coolcmyk/orion-freecad/references/camera_mechanical/dwg_front_view.png

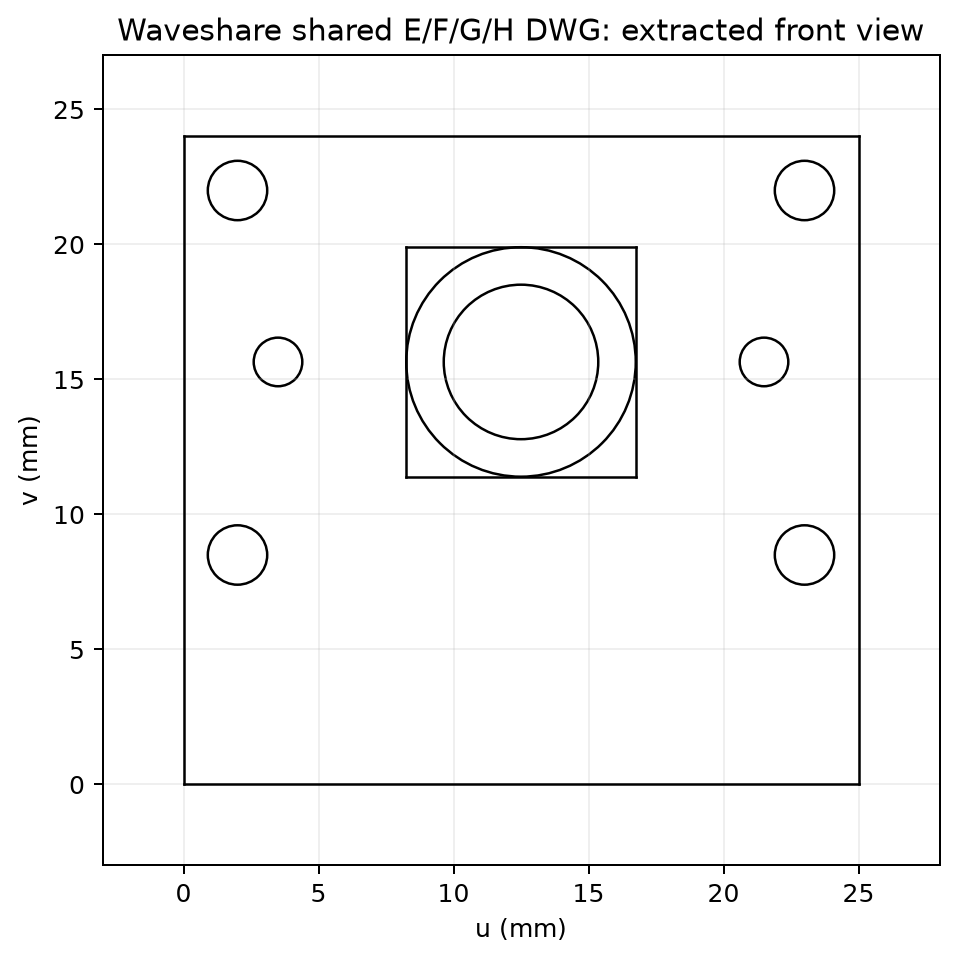
references/camera_mechanical/dwg_front_view.png
