coolcmyk/orion-freecad/screenshots/arm_top_esc_plan.png

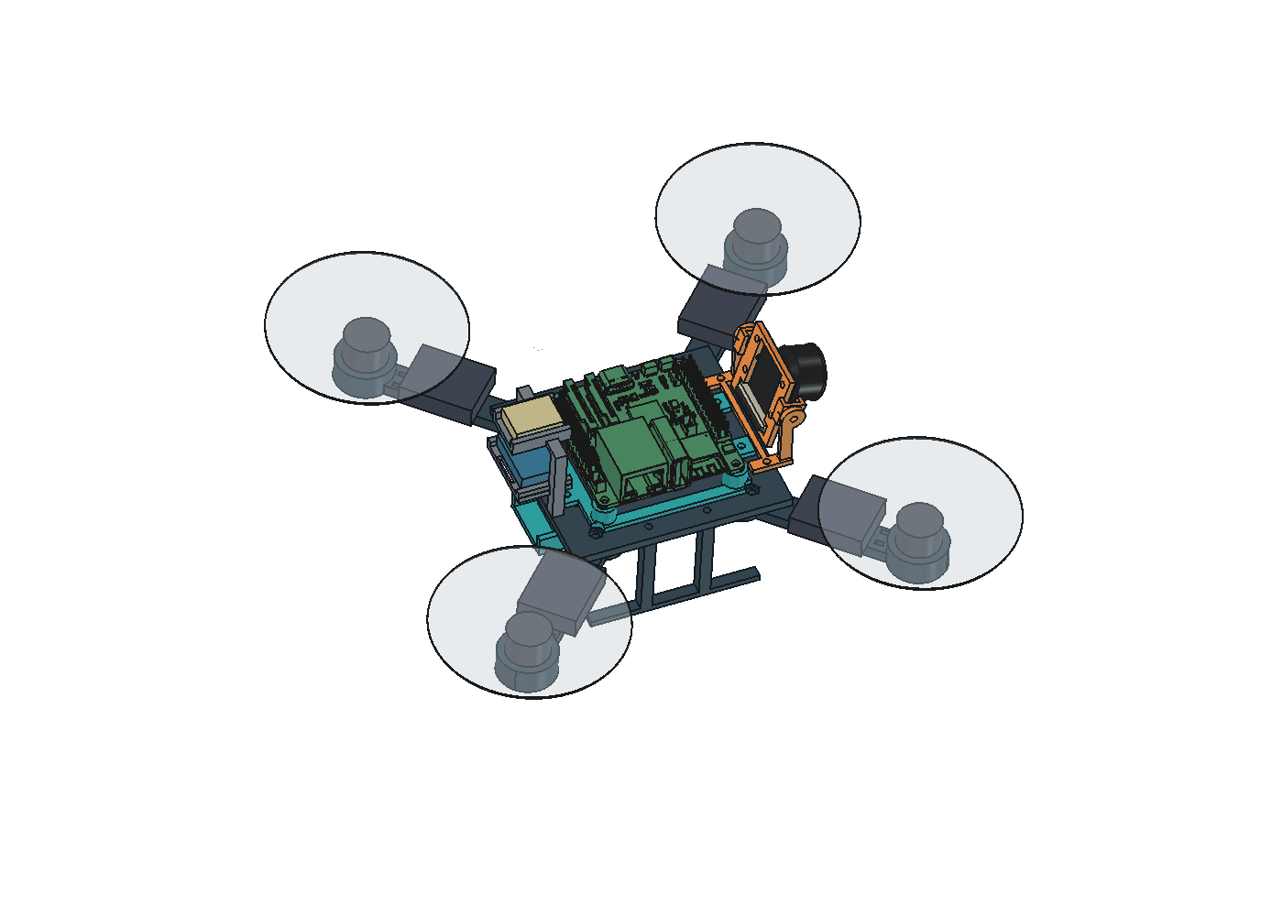
screenshots/arm_top_esc_plan.png
