coolcmyk/orion-freecad/screenshots/camera_forward_lean.png

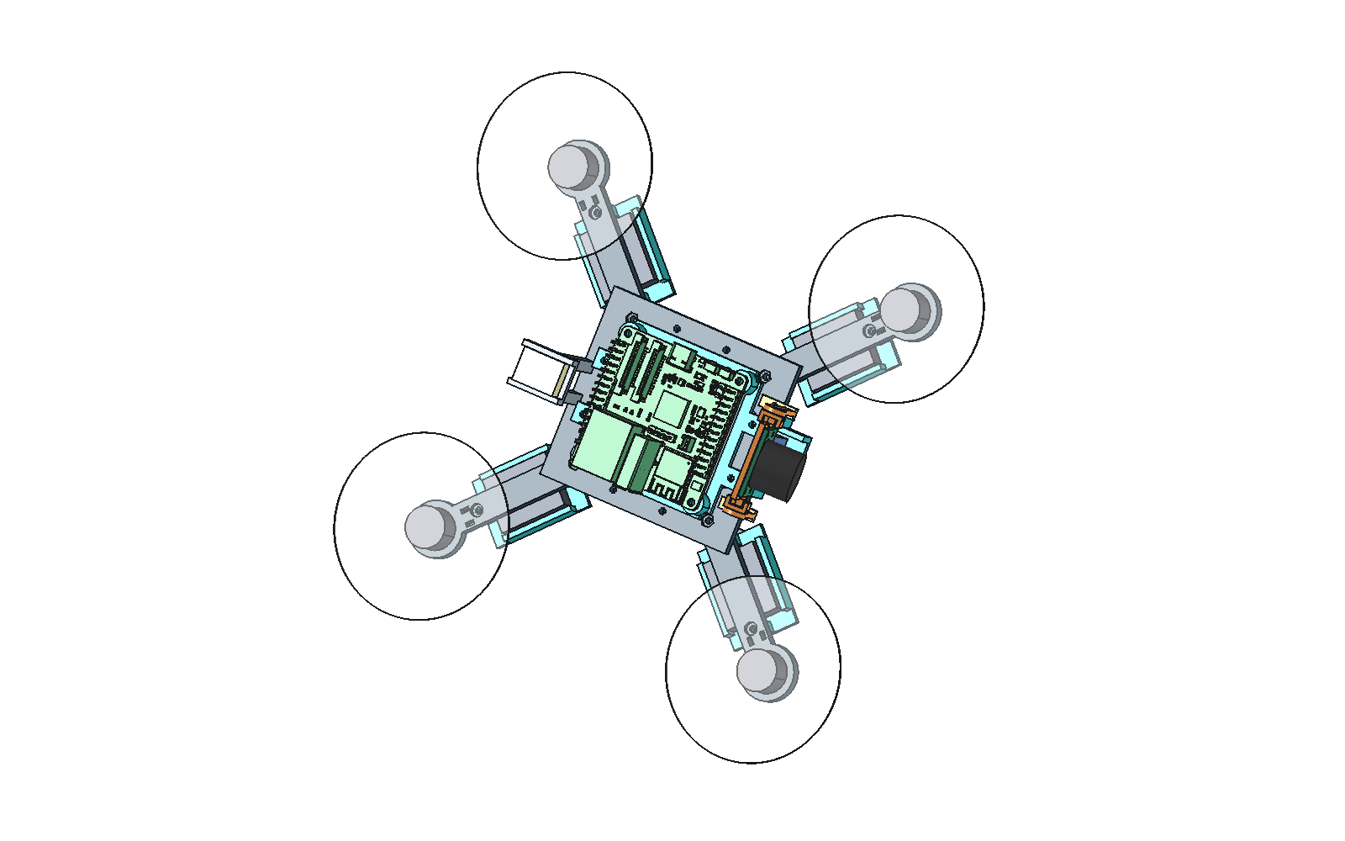
screenshots/camera_forward_lean.png
