coolcmyk/orion-freecad/screenshots/camera_g_integrated.png

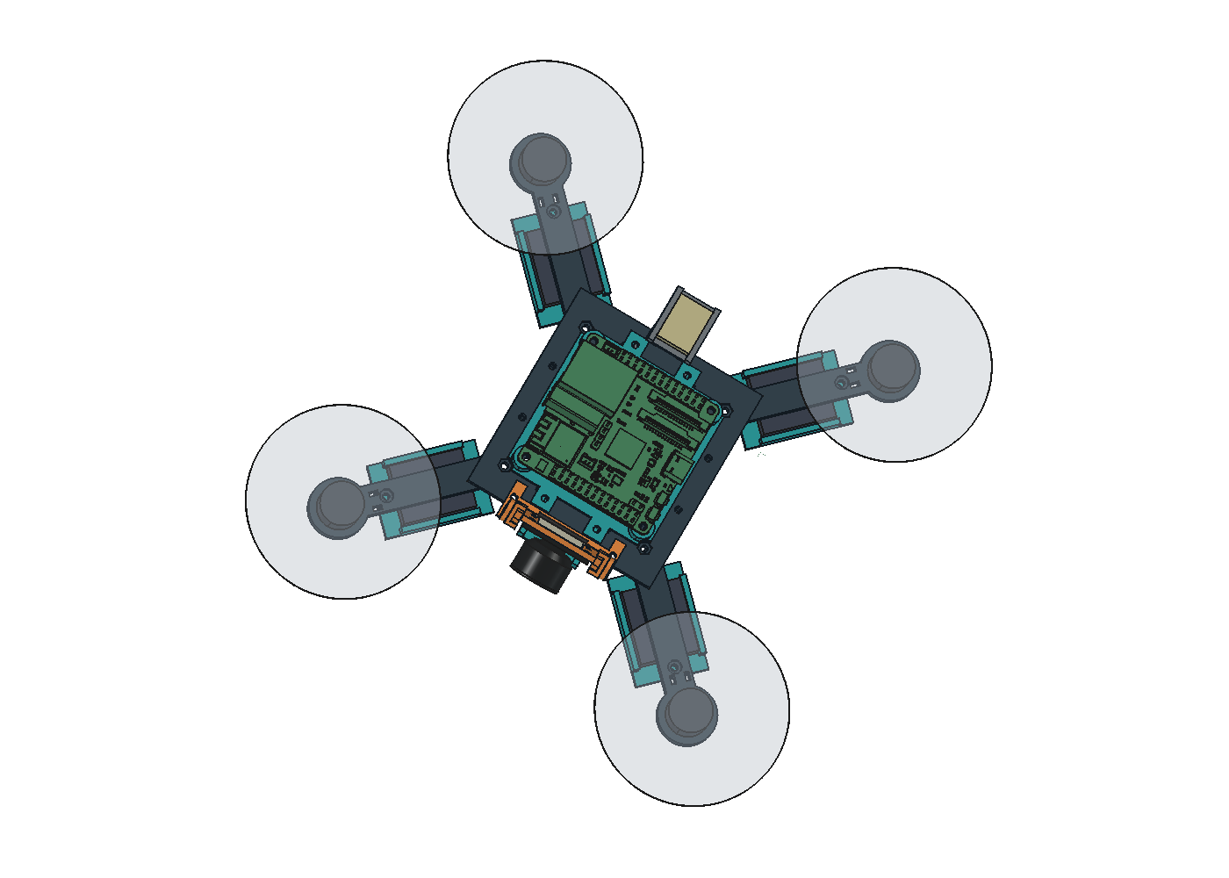
screenshots/camera_g_integrated.png
