coolcmyk/orion-freecad/screenshots/clearance_side.png

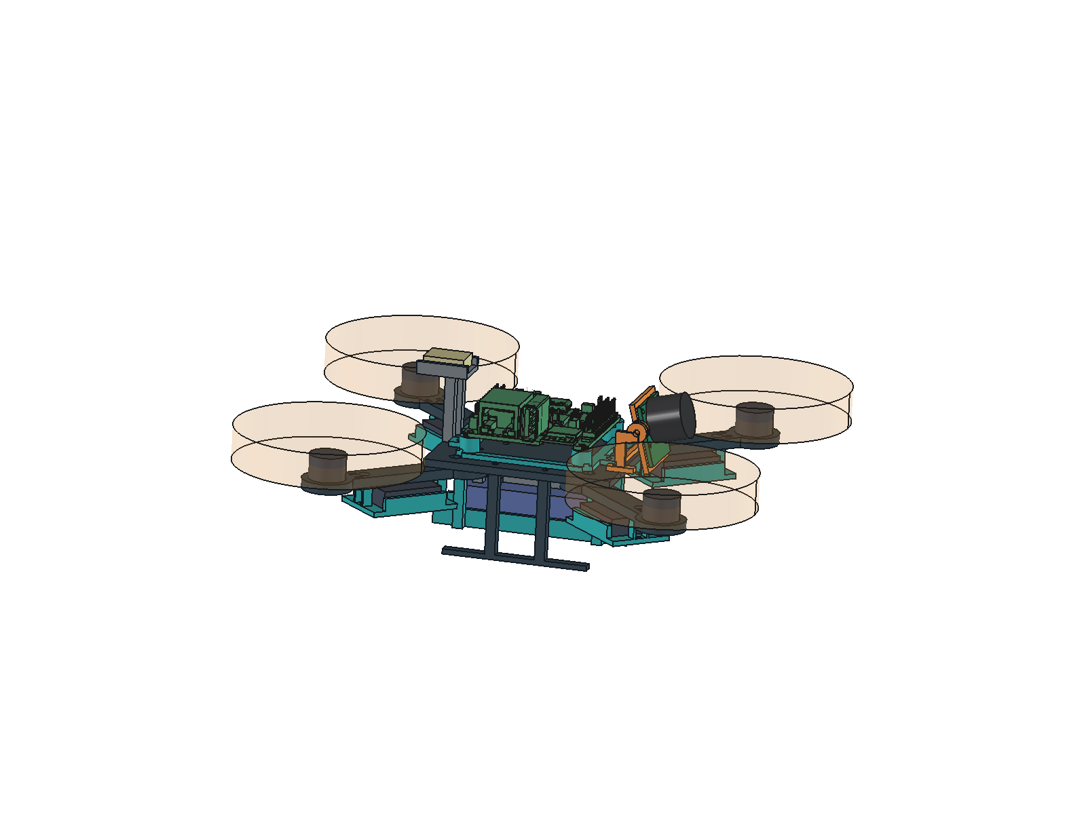
screenshots/clearance_side.png
