coolcmyk/orion-freecad/screenshots/isometric.png

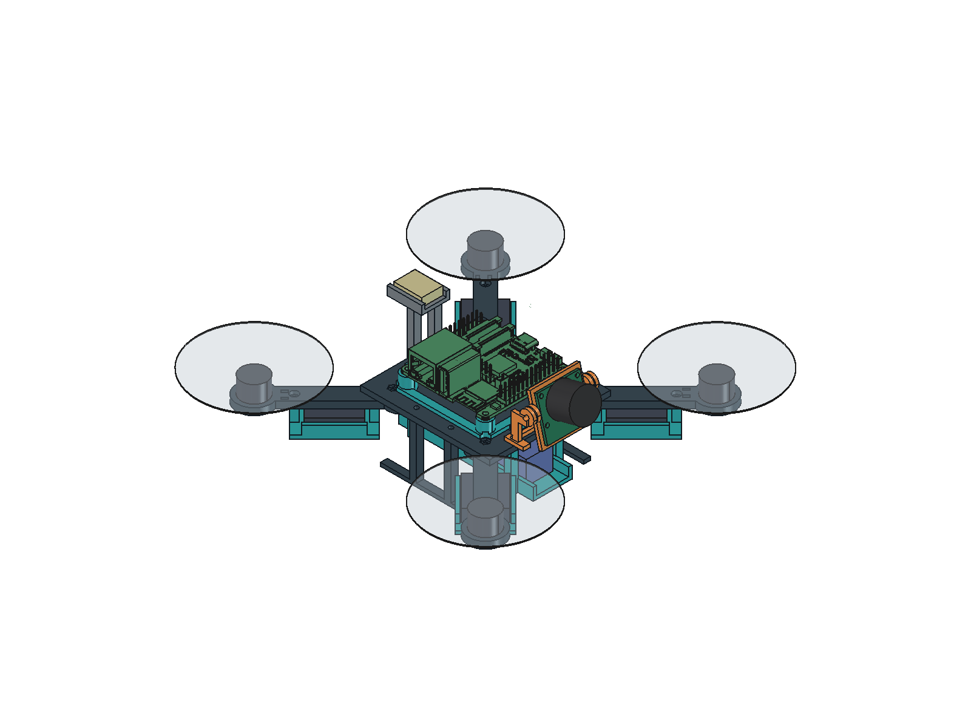
screenshots/isometric.png
