coolcmyk/orion-freecad/screenshots/sensor_battery_side.png

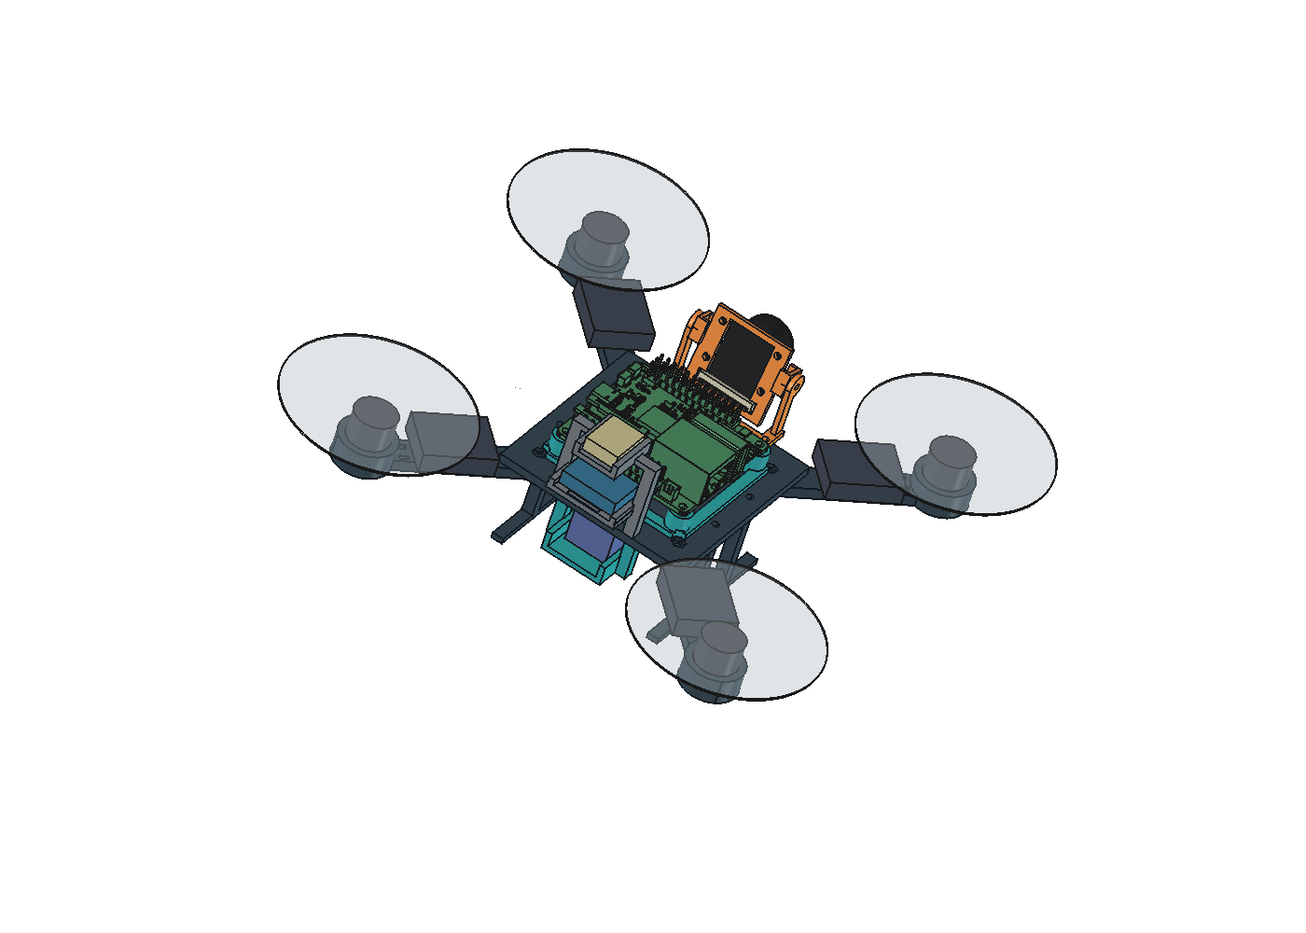
screenshots/sensor_battery_side.png
