coolcmyk/orion-freecad/screenshots/top.png

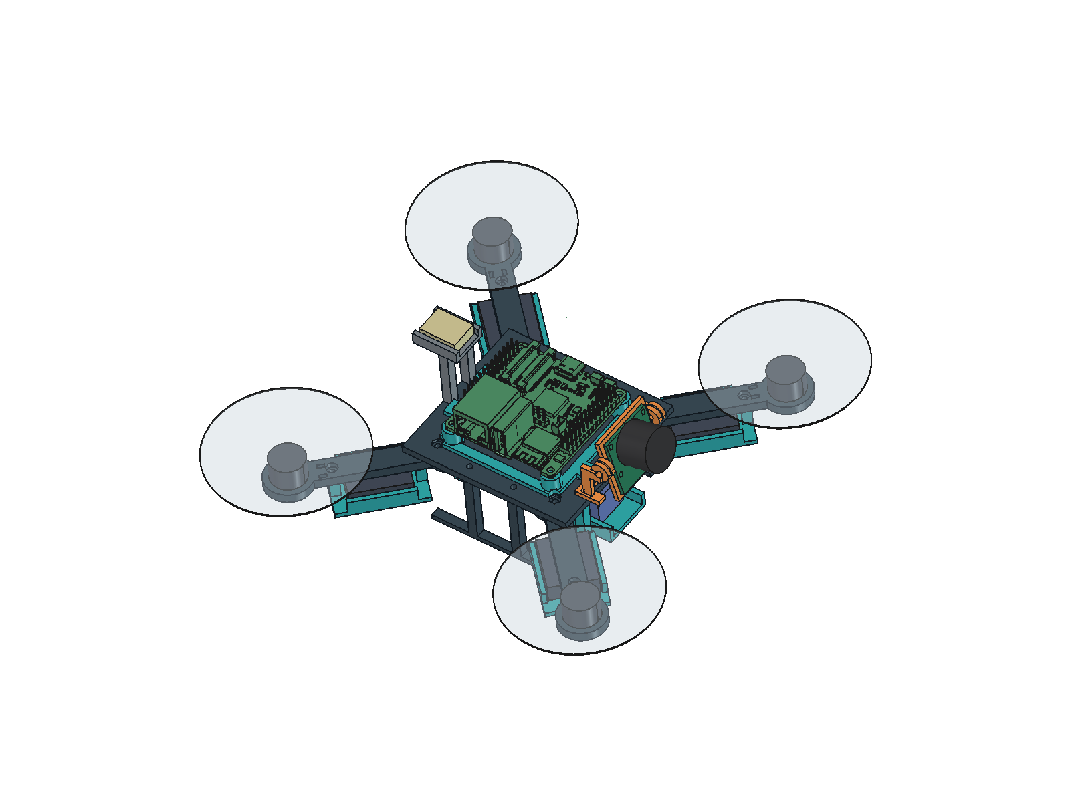
screenshots/top.png
