coolcmyk/orion-freecad/screenshots/exploded_printed_parts.png

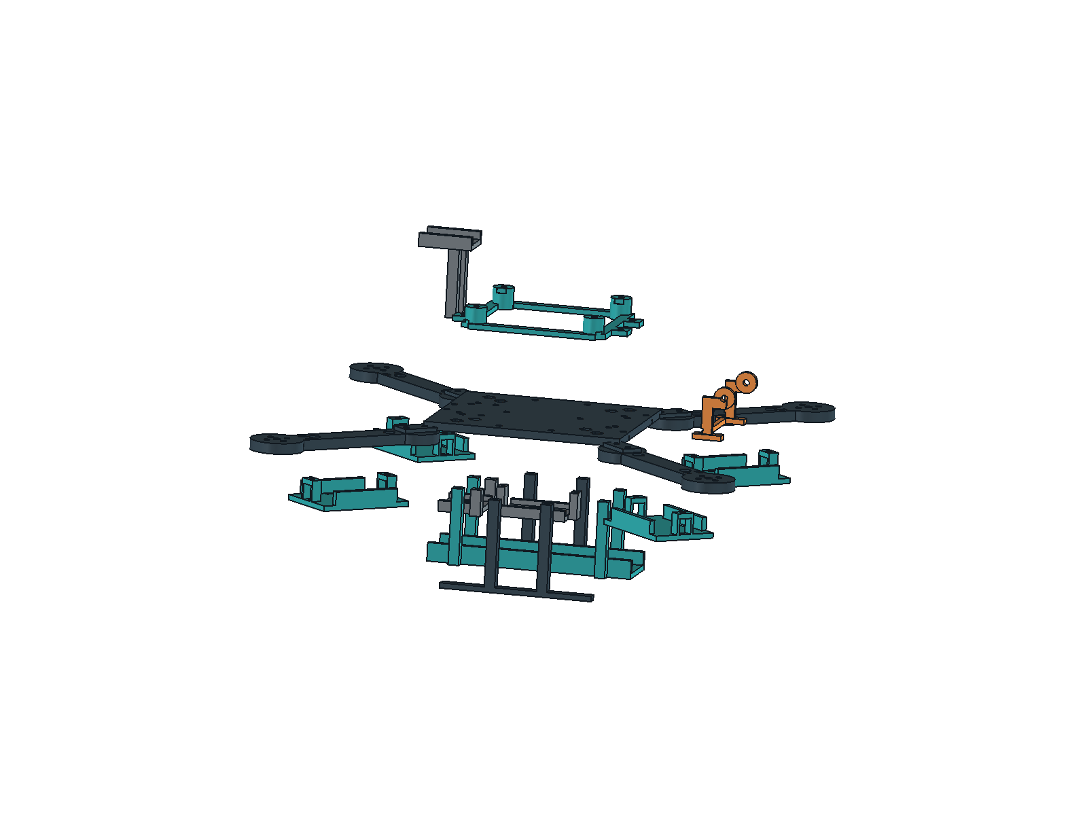
screenshots/exploded_printed_parts.png
