coolcmyk/orion-freecad/export/prototypes/ORION_center_base.stl

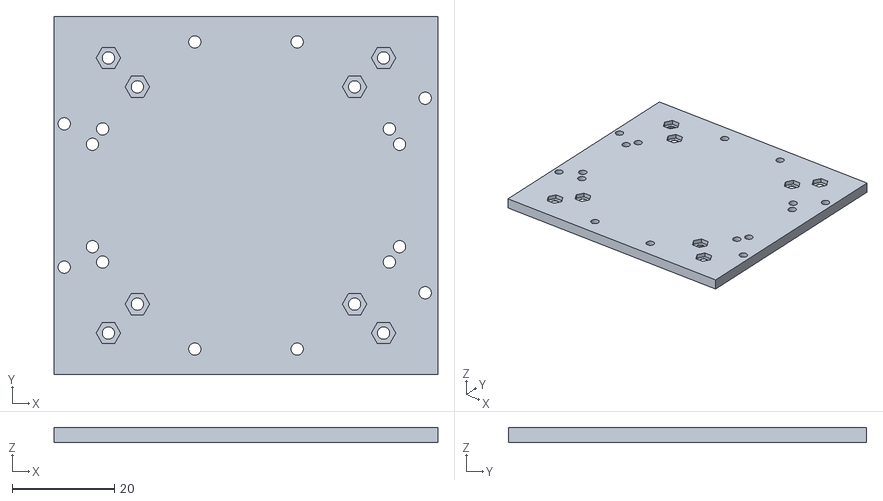
[picture p19: CAD file, 2026-10-10]
export/prototypes/ORION_center_base.stl
75.0 x 70.0 x 3.00
