coolcmyk/orion-freecad/references/camera_g_reconstructed/Waveshare_Camera_G.step

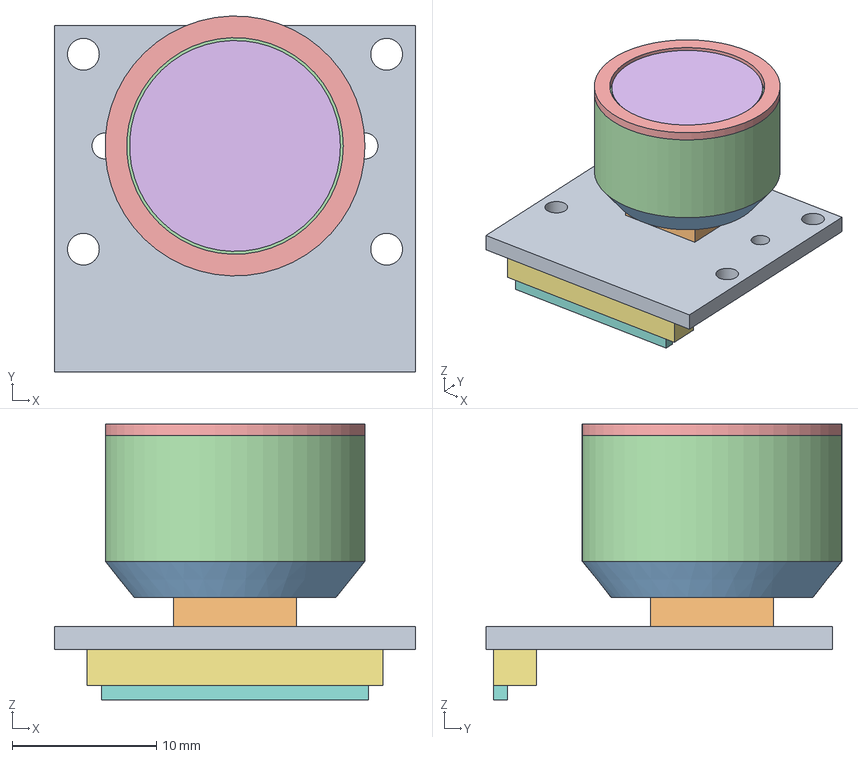
[picture p20: CAD file, 2026-10-10]
references/camera_g_reconstructed/Waveshare_Camera_G.step
25.0 x 24.6 x 19.1 mm
CameraGPCB
CameraGSensorHousing
CameraGLensShoulder
CameraGFisheyeBarrel
CameraGFocusRim
CameraGOpticalFace
CameraGRearFFC
CameraGFFCLatch
