coolcmyk/orion-freecad/export/prototypes/ORION_gps_mount.stl

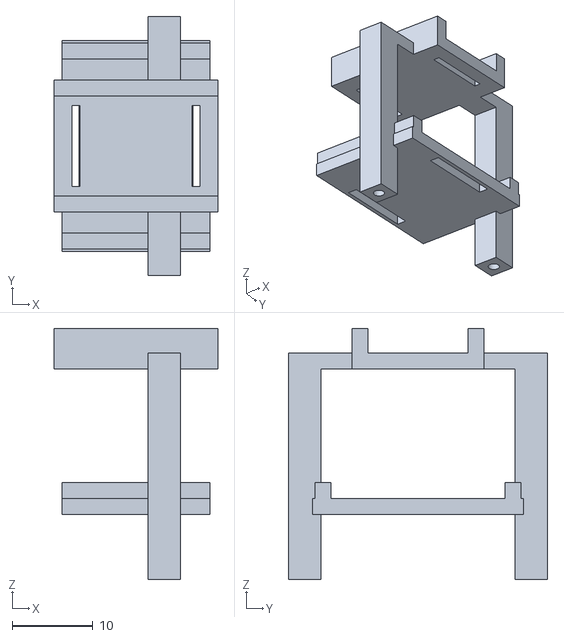
[picture p21: CAD file, 2026-10-10]
export/prototypes/ORION_gps_mount.stl
20.2 x 32.0 x 31.0
