coolcmyk/orion-freecad/export/prototypes/ORION_battery_mount.stl

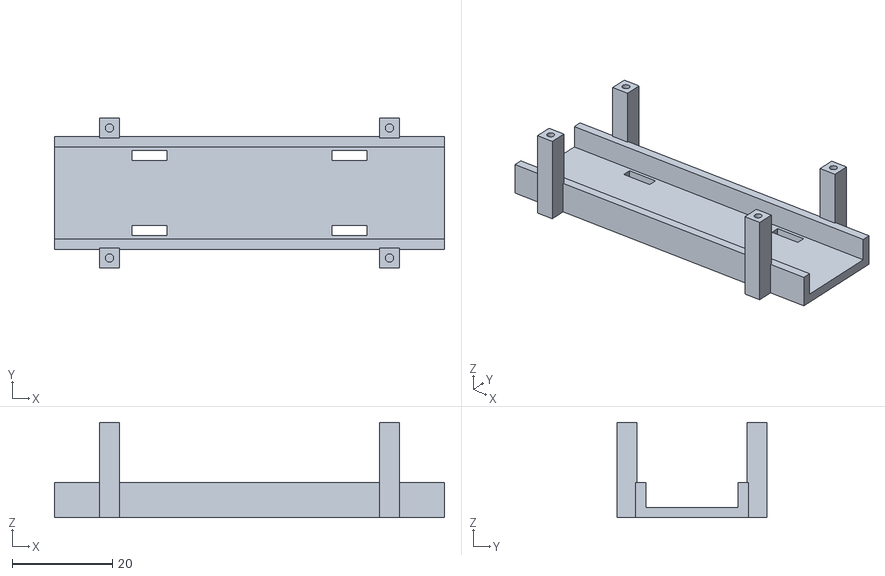
[picture p22: CAD file, 2026-10-10]
export/prototypes/ORION_battery_mount.stl
78.0 x 30.0 x 19.0
