coolcmyk/orion-freecad/export/prototypes/ORION_arm.stl

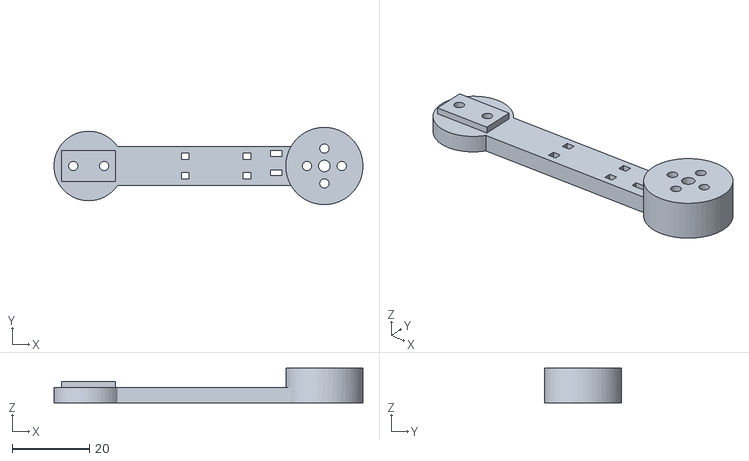
[picture p23: CAD file, 2026-10-10]
export/prototypes/ORION_arm.stl
80.0 x 20.0 x 9.00
