coolcmyk/orion-freecad/export/prototypes/ORION_camera_base_mount.stl

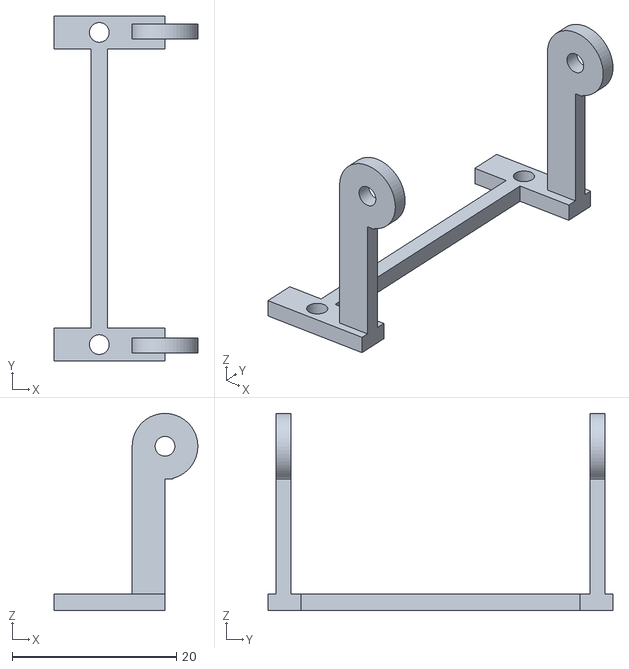
[picture p24: CAD file, 2026-10-10]
export/prototypes/ORION_camera_base_mount.stl
17.5 x 42.0 x 24.0
