coolcmyk/orion-freecad/export/prototypes/ORION_camera_mount.stl

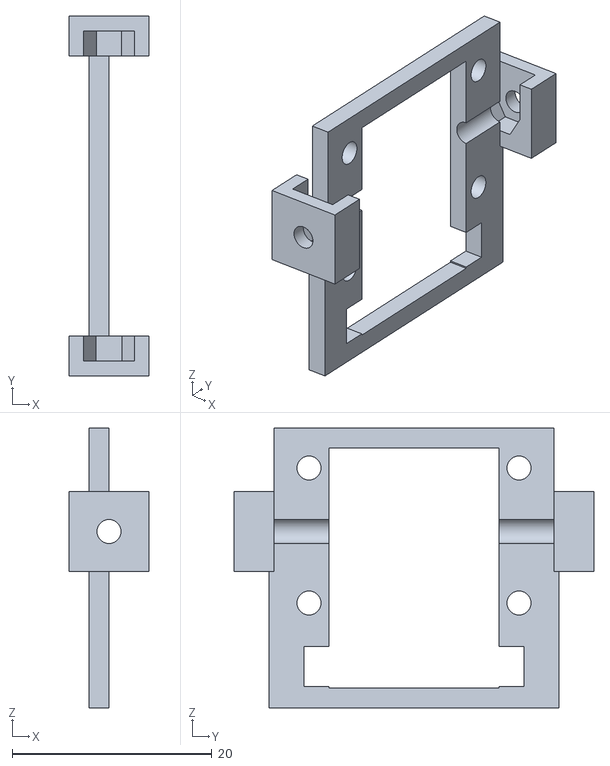
[picture p25: CAD file, 2026-10-10]
export/prototypes/ORION_camera_mount.stl
8.00 x 36.0 x 28.0
