coolcmyk/orion-freecad/export/prototypes/ORION_tolerance_coupon.stl

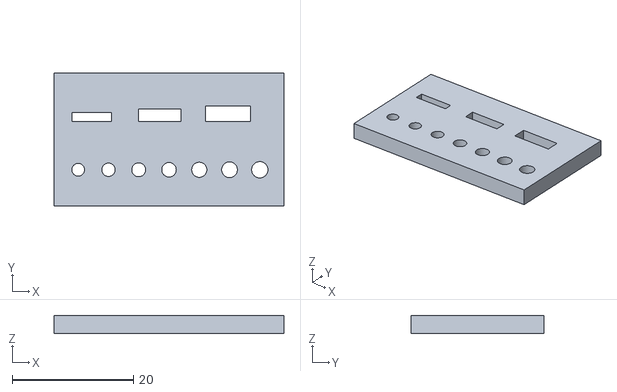
[picture p26: CAD file, 2026-10-10]
export/prototypes/ORION_tolerance_coupon.stl
38.0 x 22.0 x 3.00
