coolcmyk/orion-freecad/export/prototypes/ORION_p4_holder.stl

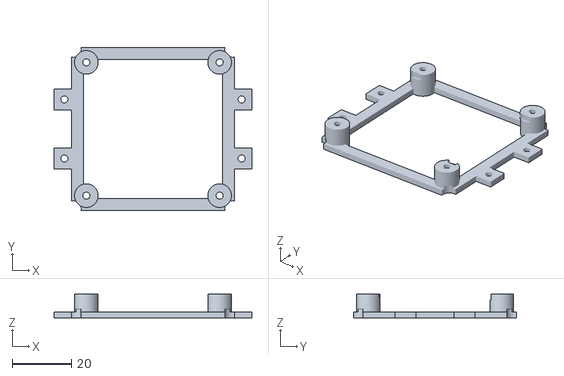
[picture p27: CAD file, 2026-10-10]
export/prototypes/ORION_p4_holder.stl
67.0 x 55.0 x 8.00
