coolcmyk/orion-freecad/export/prototypes/ORION_landing_skid.stl

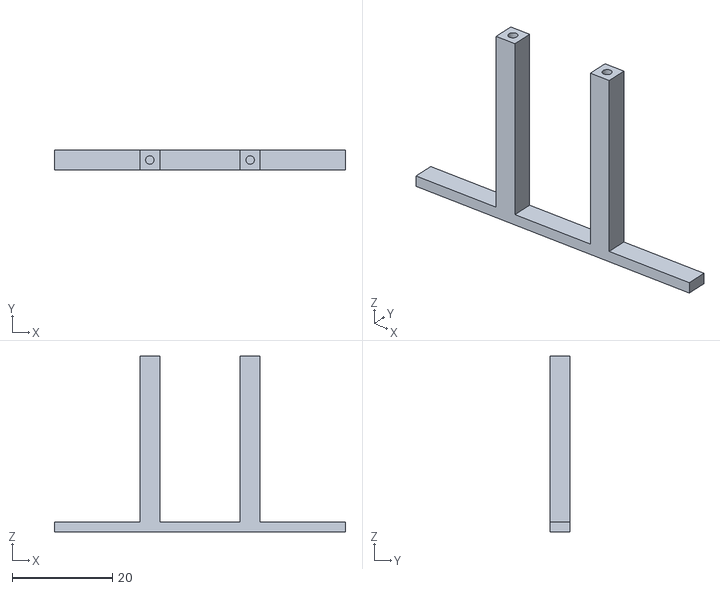
[picture p28: CAD file, 2026-10-10]
export/prototypes/ORION_landing_skid.stl
58.0 x 4.00 x 35.0
