coolcmyk/orion-freecad/(list of files, cad)

Other CAD files:
references/camera_mechanical/RPi_Camera_E_F_G_H_Mechanical.dxf
references/ESP32-P4-NANO-20260331.dxf
references/camera_g_reconstructed/Waveshare_Camera_G.FCStd
references/camera_mechanical/RPi_Camera_E_F_G_H_Mechanical.dwg
