coolcmyk/orion-freecad/references/camera_g_reconstructed/camera_g.png

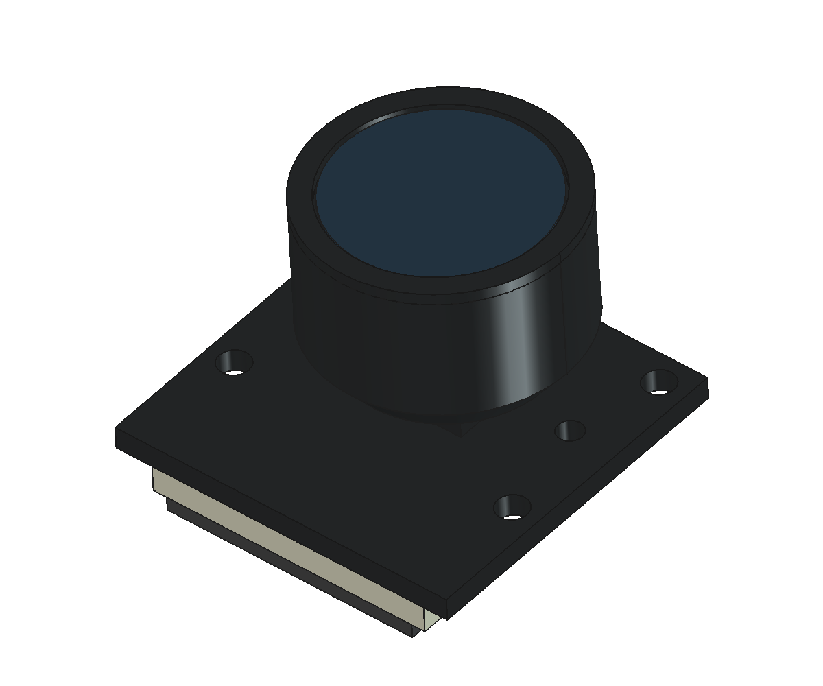
references/camera_g_reconstructed/camera_g.png
