coolcmyk/orion-freecad/(commit log)

2026-10-10 Add ORION FreeCAD frame prototype and project assets
    [ESP32-P4-NANO-20260331.dxf, ORION_arm.stl, ORION_battery_mount.stl, ORION_camera_base_mount.stl, ORION_camera_mount.stl, ORION_center_base.stl, ORION_esc_holder.stl, ORION_gps_mount.stl]
2026-10-10 Reconstruct Waveshare Camera G and revise camera mount
    [ORION_camera_base_mount.stl, ORION_camera_mount.stl, ORION_center_base.stl, RPi_Camera_E_F_G_H_Mechanical.dwg, RPi_Camera_E_F_G_H_Mechanical.dxf, Waveshare_Camera_G.FCStd, Waveshare_Camera_G.step, fasteners.csv]
2026-10-10 Replace ESC trays with integrated top retention and remove power placeholder
    [ORION_arm.stl, ORION_center_base.stl, ORION_esc_holder.stl, ORION_power_mount.stl, fasteners.csv]
2026-10-10 Place ESCs on raised motor arms and compact sensor and battery mounts
    [ORION_arm.stl, ORION_battery_mount.stl, ORION_center_base.stl, ORION_gps_mount.stl, ORION_imu_mount.stl, fasteners.csv, measurements.csv]
2026-10-10 Write illustrated printing and assembly guide
